ktanino10/copilot-cli-inverted-pendulum-m5stick/docs/demo/assets/duck.gif

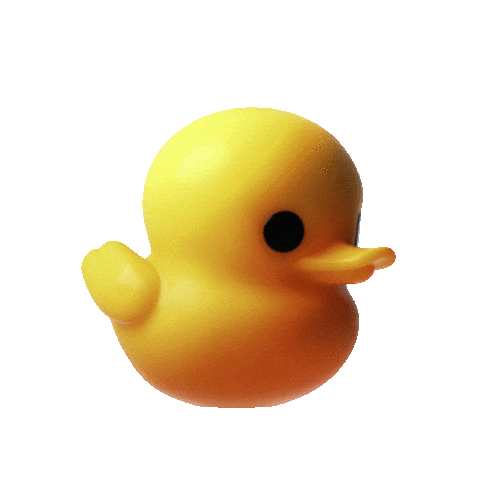
docs/demo/assets/duck.gif
