ktanino10/copilot-cli-inverted-pendulum-m5stick/docs/demo/assets/github-mark.png

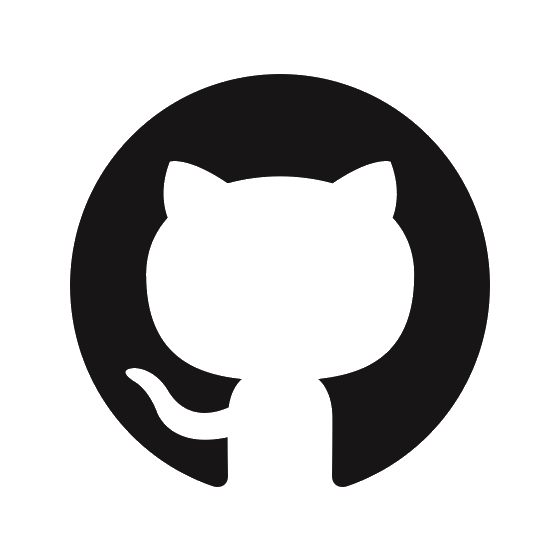
docs/demo/assets/github-mark.png
