ktanino10/copilot-cli-inverted-pendulum-m5stick/media/servo_test_20260418.jpg

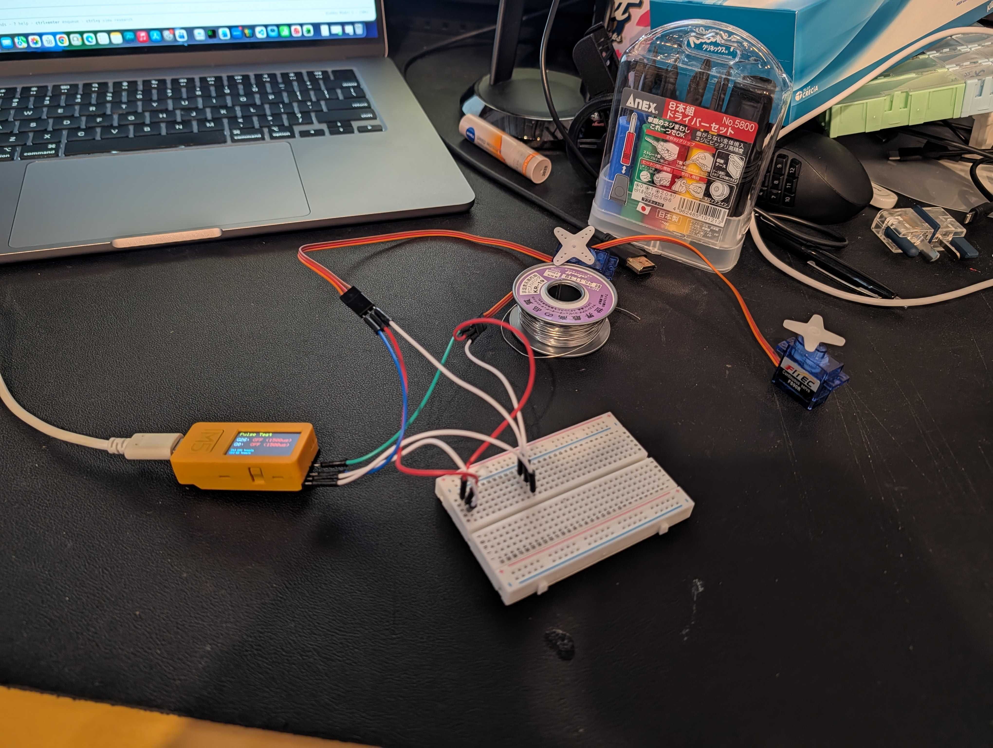
media/servo_test_20260418.jpg
