ktanino10/copilot-cli-inverted-pendulum-m5stick/octocat_display/duck_img.h

// duck - 110x110 RGB565 (byte-swapped, rotated 90° CCW)
const uint16_t duck_img[12100] PROGMEM = {
  0x8208, 0x8208, 0x8208, 0x8208, 0x8208, 0x8208, 0x8208, 0x8208, 0x8208, 0x8208, 0x8208, 0x8208, 0x8208, 0x8208, 0x8208, 0x8208,
  0x8208, 0x8208, 0x8208, 0x8208, 0x8208, 0x8208, 0x8208, 0x8208, 0x8208, 0x8208, 0x8208, 0x8208, 0x8208, 0x8208, 0x8208, 0x8208,
  0x8208, 0x8208, 0x8208, 0x8208, 0x8208, 0x8208, 0x8208, 0x8208, 0x8208, 0x8208, 0x8208, 0x8208, 0x8208, 0x8208, 0x8208, 0x8208,
  0x8208, 0x8208, 0x8208, 0x8208, 0x8208, 0x8208, 0x8208, 0x8208, 0x8208, 0x8208, 0x8208, 0x8208, 0x8208, 0x8208, 0x8208, 0x8208,
  0x8208, 0x8208, 0x8208, 0x8208, 0x8208, 0x8208, 0x8208, 0x8208, 0x8208, 0x8208, 0x8208, 0x8208, 0x8208, 0x8208, 0x8208, 0x8208,
  0x8208, 0x8208, 0x8208, 0x8208, 0x8208, 0x8208, 0x8208, 0x8208, 0x8208, 0x8208, 0x8208, 0x8208, 0x8208, 0x8208, 0x8208, 0x8208,
  0x8208, 0x8208, 0x8208, 0x8208, 0x8208, 0x8208, 0x8208, 0x8208, 0x8208, 0x8208, 0x8208, 0x8208, 0x8208, 0x8208, 0x8208, 0x8208,
  0x8208, 0x8208, 0x8208, 0x8208, 0x8208, 0x8208, 0x8208, 0x8208, 0x8208, 0x8208, 0x8208, 0x8208, 0x8208, 0x8208, 0x8208, 0x8208,
  0x8208, 0x8208, 0x8208, 0x8208, 0x8208, 0x8208, 0x8208, 0x8208, 0x8208, 0x8208, 0x8208, 0x8208, 0x8208, 0x8208, 0x8208, 0x8208,
  0x8208, 0x8208, 0x8208, 0x8208, 0x8208, 0x8208, 0x8208, 0x8208, 0x8208, 0x8208, 0x8208, 0x8208, 0x8208, 0x8208, 0x8208, 0x8208,
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
  0x8208, 0x8208, 0x8208, 0x8208, 0x8208, 0x8208, 0x8208, 0x8208, 0x8208, 0x8208, 0x8208, 0x8208, 0x8208, 0x8208, 0x8208, 0x8208,
  0x8208, 0x8208, 0x8208, 0x8208, 0x8208, 0x8208, 0x8208, 0x8208, 0x8208, 0x8208, 0x8208, 0x8208, 0x8208, 0x8208, 0x8208, 0x8208,
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
};
