ktanino10/copilot-cli-inverted-pendulum-m5stick/(commit log)

2026-04-12 初期セットアップ: README追加
    Interface誌2025年9月号の倒立振子プロジェクトの初期README。
    ハードウェア構成、配線、ライブラリ情報、PIDデフォルト値を記載。
2026-04-12 サーボモータ動作テストスケッチ追加
    FS90Rサーボの動作確認用。Aボタンで正転/逆転/停止を切り替え。
2026-04-13 docs: 購入部品リスト追加
2026-04-13 docs: Copilot CLI プロジェクトとしてREADME刷新 (日英バイリンガル)
2026-04-13 docs: 参考リンクにしんさんのブログ記事を追加
2026-04-15 docs: PID制御 理論編を追加 / Add advanced PID theory reference
    運動方程式（ラグランジュ導出）、状態空間表現、カルマンフィルタの
    完全な定式化、安定性解析（フルビッツ判定）、LQR/MPC/RL等の
    発展的手法を数式付きで解説する上級者向け技術文書を追加。
2026-04-16 docs: replace LaTeX table notation with rendered symbols in pid theory
    Agent-Logs-Url: https://github.com/ktanino10/copilot-cli-inverted-pendulum-m5stick/sessions/5fc2fae2-76e4-4516-99dc-65c427066bf1
2026-04-16 docs: switch display equations to fenced math blocks
    Agent-Logs-Url: https://github.com/ktanino10/copilot-cli-inverted-pendulum-m5stick/sessions/1d5b6d02-fe36-433c-b3ab-e53c90e8f2ca
2026-04-16 fix: 数式を画像レンダリングに変更 / Switch to image-based math rendering
    GitHub の <math-renderer> Web Component がブラウザ環境によって
    動作しない問題を回避するため、codecogs SVG画像に切り替え。
    すべての数式がJavaScript不要で表示可能に。
2026-04-16 feat: M5StickC Plus2 対応 / Port firmware to M5StickC Plus2
    - M5StickCPlus.h → M5StickCPlus2.h に変更
    - M5.Lcd → StickCP2.Display API に移行
    - M5.Imu → StickCP2.Imu.getImuData() に移行
    - M5.Axp.GetBatVoltage() → StickCP2.Power.getBatteryLevel()
    - cfg.output_power = true で5V外部出力を有効化
    - FQBN: m5stack_stickc_plus2
    - servo_test, inverted_pendulum 両方を Plus2 対応済み
2026-04-16 docs: Plus2移植トラブルシュートを進捗ログに追加 / Add Plus2 migration troubleshooting guide
    Plus → Plus2 移植時に発生した4つの問題（画面表示、5V出力、
    ボタン制御、モーター停止）の原因と対策を表形式で記録。
    API対応表も追加し、同じキットでPlus2を使う人の参考に。
2026-04-16 fix: ステッカー画像の色をバイトスワップで修正 / Fix sticker color byte order
    M5GFX(LovyanGFX)のpushImageはバイトスワップされたRGB565を
    期待するため、全4画像のピクセルデータを再変換。
    [copilot_img.h, duck_img.h, mascot_img.h, octocat_img.h]
2026-04-16 feat: Copilot GIFアニメーション再生機能を追加 / Add animated GIF playback
    copilot_sticker.gif を87フレーム(60x60 RGB565)に変換し、
    Bボタンでアニメーション再生/停止。Aボタンで静止画切替。
    Flash使用率36%。
2026-04-16 feat: 全キャラGIFアニメ + 90°回転対応 / All stickers animated & rotated 90° CCW
    Copilot/Duck/Mascot の3キャラをGIFアニメーション再生可能に。
    全画像を反時計回り90°回転（倒立振子搭載時に正面向き）。
    Flash使用率71%。Aボタンで静止画切替、Bボタンでアニメ再生。
2026-04-18 docs: 4/18 両輪駆動成功のログと写真を追加 / Log dual servo success
    pulse_drive方式で両サーボ安定駆動に成功した記録。
    追加の問題2件（パルス漏れ、ボタン応答）と対策を記載。
    テスト時の写真を media/ に追加。
2026-04-18 docs: YouTubeリンクを追加 / Add YouTube video link
    両輪サーボ駆動テストの動画をサムネイル付きで埋め込み。
    https://www.youtube.com/watch?v=syauXEm0TFY
2026-04-18 feat: PID符号修正 + リアルタイムチューニングUI + CSVログ
    - PID出力の符号を反転（車輪が傾き方向に追いかけるように）
    - 全PIDパラメータを0初期化（ゼロからチューニング）
    - BtnA短押し: ON/OFF、長押し: パラメータ選択切替
    - BtnB短押し: 選択中パラメータ+step、長押し: ステップ変更
    - シリアルCSV出力（CERN ROOT解析用データ収集対応）
    - servo_stop()をパルスなし方式に修正
    [inverted_pendulum.ino]
2026-04-18 fix: PITCH_OFFSET削除+角度自動基準+待機短縮 / Fix angle offset and response
    - PITCH_OFFSET=81.0を削除（Angleが常に大きくPID_resetされ続けた原因）
    - ONにした瞬間の角度を基準(Pitch_offset)として自動設定
    - wait_countを200→50に短縮（2秒→0.5秒で応答開始）
    - ANGLE_LIMITを30→45に拡大
    [inverted_pendulum.ino]
2026-04-18 fix: ANGLE_LIMIT超過でモーター自動OFFを無効化
    角度超過時はPIDリセット+サーボ停止だけ行い、motor_swはONのまま。
    直立に戻せば自動復帰。手で支えながらの調整が容易に。
    [inverted_pendulum.ino]
2026-04-18 fix: 両モーター +power/+power に変更
    motor_dir_testで+cmd/+cmdが前進と確認済み。
    前に傾けたら前に進む方向に統一。
    [inverted_pendulum.ino]
2026-04-18 fix: モーター方向を確定 +power/-power（実機テスト済み）
    4パターン方向テストで Mode3(+100/-100) が前進と確認。
    powerL = +power, powerR = -power に確定。
    [inverted_pendulum.ino, motor_dir_test.ino]
2026-04-18 debug: シンプルP制御のみに簡素化+getPitch軸戻し
    方向問題のデバッグ用にPID_ctrlをpower=kp*Angleだけに簡素化。
    Speed/I_Angle等の蓄積を排除して純粋な方向確認。
2026-04-18 fix: getPitch()をasin(-acc[2])に変更 — 前後応答確認！
    IMU軸確認ツールでZ軸が前後傾きと特定。
    atan2では直立付近で符号が正しく反転しなかったため、
    asin(-acc[2])で直接角度変換に変更。
    前=前、後ろ=後ろの動作を実機確認 ✅
    [inverted_pendulum.ino]
2026-04-18 docs: 4/18 方向制御確立のログを追加 / Log direction control establishment
    IMU軸特定手順、モーター方向4パターンテスト、
    確定した制御パラメータ、解決した問題5件を日英で記録。
    他の人が同じハードで作る際のガイドとして。
2026-04-18 fix: getPitch/ジャイロ符号を反転 — 後傾時の方向修正
    後ろに倒れそうなとき前に進んでいた問題を修正。
    asin(-acc[2])→asin(acc[2])、-gyro[2]→gyro[2]に変更。
    [inverted_pendulum.ino]
2026-04-18 feat: Bボタンで直立基準オフセット調整 + PIDゲイン増加
    重心位置のずれに対応するためBボタンでPitch_offsetを±0.5°調整可能に。
    PIDゲインをkp=30, ki=3, kd=2に増加。
2026-04-18 feat: リアルタイムモニター + 自動チューニングスクリプト
    tools/monitor.py: リアルタイムAngle/power表示+コマンド送信+全データCSV自動保存
    tools/auto_tune.py: パラメータスイープで安定時間を自動計測
2026-04-18 data: 42パターン自動PIDスイープ完了！
    最安定パラメータ: kp=10, kd=2 (stable=5.0s, mean_angle=0.1°)
    安定領域: kp=10-25, kd=2-15
    kp=50は高すぎた（振動→倒れる）
    [autotune_20260418_232105.csv]
2026-04-25 refactor: n_shinichi氏準拠のクリーン版に全面書き換え
    重大な差分を全修正:
    - ジャイロ軸: Z軸→X軸（実機テストで確認）
    - getPitch: asin→atan2（n_shinichi氏と同じ）
    - Pitch_offset: 動的→81固定（n_shinichi氏と同じ）
    - PID符号: 二重反転を解消、n_shinichi氏と同じ構造
    - power制限: ±400制限を撤廃
    - I_Angle: constrain→300でリセット（n_shinichi氏と同じ）
    - wait_count: 50→200（n_shinichi氏と同じ）
    - ANGLE_LIMIT: Angle→Pitch_filter、45→30（n_shinichi氏と同じ）
    [inverted_pendulum.ino, motor_dir_test.ino]
2026-04-25 tune: Pitch_offset=82.4 — USB無しで10秒静止達成！🎉
    n_shinichi氏準拠クリーン版 + ジャイロX軸修正の効果で
    BAT端子3.7Vでも10秒間の自立バランスを確認。
    ジャイロ軸の間違い(Z→X)が最大の原因だった。
    [inverted_pendulum.ino]
2026-04-25 fix: ボタン処理を100msループに移動（1秒ループでは反応しない）
2026-04-25 fix: Pitch_offset=2.5（実測値）+ ANGLE_LIMIT復元
    直立時のPitch実測値=-2.5° → offset=2.5で直立=0°に。
    n_shinichi氏の81はIMU取り付け向きが違うため使えなかった。
    ANGLE_LIMIT=±30に戻し、PID_ctrlが正しく起動するように。
    [inverted_pendulum.ino]
2026-04-25 fix: Pitch_offset=0.1（直立USB実測）+ Angle=PF-offset計算修正
    直立状態でUSB繋いでPF=0.1を実測。
    Angle = Pitch_filter - Pitch_offset で直立=0°。
    PIDが正しく動作しモーターが傾きに応答することを確認。
    [inverted_pendulum.ino]
2026-04-25 feat: Z軸直接角度変換+PID符号反転+ANGLE_LIMIT拡大で大進歩
    - getPitch: atan2→acc[2]*90（Z軸直接、符号反転問題を完全回避）
    - PID符号: 反転して正しい方向に
    - ANGLE_LIMIT: ±30→±60（大角度でもPID継続）
    - Pitch_offset: 0（Z軸直接なのでoffset不要）
    - 微細な角度で前後正しく応答、大角度でも方向維持
2026-04-25 fix: atan2境界問題を根本解決 — 直立を0°に移動
    旧: atan2(-acc[2], -acc[1]) → 直立=-89.8°（atan2の±90°境界付近）
    → 前後どちらに傾けても角度がマイナスになり、モーターが片方向のみ
    新: atan2(acc[1], acc[2]) → 直立=0°（境界から遠い安定領域）
    → 前傾=+角度、後傾=-角度で正しく符号が分かれる
    → ±180°境界は横倒し（90°以上）で通常動作に影響なし
    Pitch_offset: -89.8 → 0.0（直立が0°なのでオフセット不要）
    [inverted_pendulum.ino]
2026-04-25 docs: 4/25進捗ログ追加 + atan2符号修正 + README全面更新
    進捗ログ:
    - 4/18: 42パターン自動PIDスイープ + ヒートマップ可視化
    - 4/25: n_shinichi氏コード完全準拠クリーンリライト
    - ジャイロ軸 Z→X 修正（最重要修正）
    - atan2境界問題の発見と解決（直立=-90°→0°に移動）
    - 小角度PID制御成功のシリアルログ記録
    ファームウェア:
    - getPitch(): atan2(-acc[1], acc[2]) に変更
    旧版と同じ符号、直立=0°で安定
    README更新:
    - ハードウェア: Plus→Plus2に更新
    - ライブラリ: RemoteXY削除、M5StickCPlus2追加
    - リポジトリ構成: tools/, motor_dir_test/, octocat_di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
    [inverted_pendulum.ino]
2026-04-30 feat: 転倒ログ診断とROOT可視化を追加
    - 詳細ログX行を追加し、Angle/dAngle/PID項/IMU/出力を記録
    - ON時に現在姿勢を自動ゼロ合わせするzero/reference処理を追加
    - 前後非対称補正とデバッグ用コマンドを追加
    - 速度/最低出力補正の試行結果を反映し、現在は安全側設定に整理
    - failure_log_*.csv を保存
    - visualize_root.pyを詳細ログCSV対応に刷新
    - ROOTファイルとmatplotlib/ROOT PNGを生成
    - READMEに5/1の実験ログ、可視化リンク、次回候補を追記
    [failure_log_backward_run.csv, failure_log_latest.csv, failure_log_oscillation.csv]
2026-04-30 docs: READMEに転倒ログPNGを埋め込み表示
2026-04-30 docs: READMEの理論説明とログ表示を整理
2026-04-30 docs: 理論章に用語補足ブロックを追加
2026-05-01 docs(glossary): convert math to codecogs SVG images for GitHub rendering
    GitHubネイティブの $$...$$ / $...$ 数式表記が用語集ページで
    正しくレンダリングされなかったため、pid_theory.md と同じ
    codecogs SVG 画像埋め込み形式に変換。
2026-05-01 feat(pid): 速度FB極弱で復活 + ANGLE_LIMIT を ±20 へ縮小
    転倒ログ再分析（5/2）の結論を反映:
    1. 純 P+D 制御は backward_run ログでは正常動作していたが、
    速度/位置フィードバックを全部 0 にしたため車輪が振子の真下まで
    走り続けて止まらず、結果として後ろへ逃げる挙動が必然となっていた。
    倒立振子は原理的に「角度＋車輪速度」最低 2 状態フィードバックが必要。
    → kpower=0.0001, kspd=0.15 をデフォルトに復活。
    2. oscillation ログの暴走原因は ANGLE_LIMIT (±45°) を出入りする度に
    PID_reset → 復帰時に大角度（30〜45°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
    [inverted_pendulum.ino]
2026-05-01 tools: arduino-cli を使った書き込みヘルパー upload.sh 追加
    使い方:
    ./tools/upload.sh # コンパイル + 書き込み
    ./tools/upload.sh -c # コンパイルのみ
    ./tools/upload.sh -m # 書き込み後にシリアルモニタを開く
    PORT=/dev/cu.xxx ./tools/upload.sh # ポート上書き
2026-05-01 Add wireless tuning UI: M5 web server + Mac Flask session UI
    - Firmware: WiFi + WebServer on M5StickC Plus2
    - GET / simple mobile UI
    - GET /s full status JSON (angle, dangle, P/I/D, gains)
    - GET /c?q=cmd parameter command (same syntax as serial)
    - WiFi credentials in inverted_pendulum/wifi_config.h (gitignored)
    - Mac server: tools/server.py (Flask on :5000)
    - Hosts rich session UI, proxies API to M5
    - Auto-saves test sessions to tools/data/sessions/{stamp}_{name}.{json,csv}
    - UI: tools/templates/index.html
    - START/STOP test recording with live chart (20Hz polling)
    - Session list, multi-select compare overlay, auto-diagnose hints
    - tools/run_server.sh helper, r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
2026-05-01 feat(ui): Gundam HUD theme — RX-78 / IPS interface
    - Boot sequence with system check log
    - Top status bar: clock, link/motor/power LEDs, serial #
    - Clip-path angular panels with corner brackets
    - Orbitron + Share Tech Mono fonts (Gundam HUD style)
    - Cyan/amber/red mecha color palette with neon glow
    - HUD-style angle gauge with crosshair grid + needle bar
    - Custom slider thumbs (chevron shape)
    - Combat recorder badge with REC pulse
    - Mission archive with FWD/BWD/STANDING pills
    - Tactical analysis chart with multi-trace glow
    - AI diagnostic with mecha-flavored advice strings
2026-05-01 ui: add GitHub mark + 3D stickers (Copilot/Mona/Duck)
    - GitHub mark in header (cyan glow, white-inverted)
    - GitHub mark in boot screen (rotating 8s)
    - Copilot 3D sticker beside AI DIAGNOSTIC heading
    - Mona mascot floating in bottom-right corner
    - Rubber Duck on CONTROL PARAMETERS panel (debugging vibes)
    - Footer credit: POWERED BY GITHUB COPILOT
2026-05-01 Refine UI: drop military terms, transparent Octocat PNG, add toast helper
    - Remove combat/mission/operation/engage/abort wording
    - Convert github-mark.png white background to transparent so the
    brightness/invert/cyan-glow CSS filter renders an Octocat silhouette
    on the dark HUD instead of a white square
    - Add toast(type, mascot, msg) helper with contextual mascot mapping
    (mona = standing success, duck = quick fall / errors, copilot = AI/info)
    - Wire save outcome to contextual toast notifications
2026-05-01 Add /dash analytics dashboard with 7 on-demand analyses
    New page at /dash with Gundam HUD theme, mirrors main UI aesthetic:
    - Session archive (multi-select up to 4, color-coded)
    - KPI grid (duration, stable time, max angle, RMS, peak power, sat%, osc Hz, fall dir)
    - Time-series charts via Chart.js (angle / power / P-D terms / speed)
    with alim band overlay and time normalization toggles
    - Stats & params diff table (auto-highlights cells that differ)
    Analysis bar with 7 buttons that compute and display on demand:
    - 🎯 FALL CAUSE - classify why it fell (saturation / overshoot / oscillation / cutoff / drift)
    - ⚖ SYMMETRY - forward vs backward power response asymmetry, suggests ppos/pneg a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
    [server.py]
2026-05-01 Add JP/EN language toggle, dynamic Mona widget, Copilot intro/welcome
    Language toggle (no emoji, just 'JP' / 'EN' buttons):
    - Lightweight CSS-only i18n via data-en / data-jp attributes
    (body.lang-jp [data-en]{display:none} and vice versa)
    - Persists choice via localStorage
    - Triggers Ducky toast on every language change
    Dynamic Mona widget in ATTITUDE panel:
    - Visualizes system stability through animation speed:
    * |angle| < 5° -> STABLE: slow gentle float (4s)
    * |angle| 5-15° -> WOBBLE: faster bounce (0.9s, amber halo)
    * |angle| >= 15° or |dangle| > 80 -> FALLING: rapid shake (0.18s, red halo + status blink)
    - animation-duration is set via CSS custom property from JS each poll cy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
2026-05-01 Fix i18n: render attribute via ::before; tilt+flip Mona face with angle sign
    - i18n CSS bug: previous rules only set display:none and never rendered
    the data-en/data-jp attribute values, so dual-attr empty spans showed
    nothing. Switched to [data-XX]::before { content: attr(data-XX) } so
    the active language's text actually appears.
    - Mona face now mirrors angle sign: angle >= 0 shows native orientation
    with rotate(+tilt), angle < 0 horizontally flipped (scaleX -1) with
    inverse rotation. Tilt is angle * 0.7 clamped to +/-30 deg, with a
    smooth 120ms transition for natural head tracking.
2026-05-01 Promote language switch to fullscreen Ducky splash overlay
    Replaces the small toast notification with a centered amber-glow overlay
    showing a 280px Ducky GIF, large 'JP' / 'EN' badge with neon glow, and
    mode label ('日本語モード' / 'ENGLISH MODE'). Plays a pop+bob animation
    for ~1.4s then fades out. Applied to both main UI and dashboard.
2026-05-01 feat(ui): dynamic Copilot+Ducky reactions across HUD/dash
    Copilot (analysis/recording companion):
    - TEST RECORDER: live counter (samples · seconds), pulse rate
    accelerates with elapsed time, periodic flash every 5s
    - Save success: Copilot icon scale-pop flash on /api/sessions OK
    - /dash analysis: 0.6s 'thinking' pose before result, then mood
    badge (cyan ok / amber warn / red pulse err) based on result mix
    Ducky (anomaly/debug guardian):
    - ATTITUDE: 'SAT!' Ducky pops next to Mona when |power|>=plim*0.95
    for >300ms; auto-hides on recovery
    - Global: 'LINK LOST' banner slides down from top after 3 consecutive
    /api/s failures; slides out on recovery
    - Fall moment: Ducky rolls right-bott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
2026-05-01 fix(parade): correct mascot filters (Mona was white due to nth-child shift from .pcap span)
2026-05-01 feat(dash): GREEN-zone optimization analyzer (regression + heatmap + bootstrap CI)
    GREEN-zone framework: every analysis result now starts with a banner
    showing % time within +/-5deg (the 'green stable' band) per session,
    the 80%% goal, and the single most-impactful next change to reach it.
    New analyzer 'OPTIMAL -> GREEN':
    - Per-parameter 1D regression: scatter (param value vs green-stay %)
    with moving-block bootstrap 95%% CIs (1s blocks x 400 resamples)
    - Quadratic least-squares fit; reports concavity, R^2, vertex (predicted
    optimum). Marks vertex on chart when concave and inside data range.
    - 2D Gaussian-kernel heatmap when exactly 2 params vary; shows kernel-
    predicted peak with cro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
2026-05-01 revert(ducky): remove fall-moment Ducky roller per user feedback
    Keep other Ducky roles (PWM saturation badge, link-lost banner,
    language-switch splash). Only the fall-moment roller across the screen
    was unwanted.
2026-05-01 Add per-session score + one-click APPLY params; remove fall-time Ducky
    - computeStats now derives green_ratio (% time |angle|<=5deg), mean_abs_angle,
    and a 0-100 score: duration (<=30) + green% (<=50) + tightness (<=20).
    - Server /api/sessions exposes score / green_ratio / mean_abs_angle.
    - Session list rows now show a colored SCORE badge (green/amber/red) and
    an APPLY button that pushes the saved params to the device in one click
    via /api/c. Legacy sessions get a derived score from summary fields.
    - Remove fall-time Ducky displays per request:
    * #duckSat (PWM saturation badge by Mona) and its CSS keyframes
    * QUICK FALL ducky toast -> Mona warn toast
    * drawDiag lead mascot 'duck'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
    [server.py]
2026-05-01 Boot screen: SEED-style live system check sequence
    Replace static 1.8s boot animation with a live diagnostic that types
    each line, runs a real probe, and reports OK / WARN / FAIL with a
    color-coded verdict. Lines (in order):
    HUD INTERFACE / DOM
    NETWORK STACK (navigator.onLine)
    TUNING SERVER · LOCAL API (GET /api/sessions)
    WI-FI LINK · M5STICKC (GET /api/s with 1.5s timeout)
    IMU · MPU6886 (angle field + sanity)
    KALMAN FILTER (dangle field)
    MOTOR DRIVER · DRV8833 (on field — WARN if already engaged)
    POWER · LIPO BATTERY (batt voltage thresholds)
    PID CONTROLLER (kp/kd/pneg/bias loaded)
    SESSION ARCHIVE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
2026-05-01 GitHub Pages demo + portable multi-SSID firmware
    ═══ GitHub Pages demo (docs/demo/) ═══
    Build a fully self-contained static demo of the IPS Command UI so the
    project can be browsed without owning the hardware.
    * docs/demo/index.html — generated copy of tools/templates/index.html
    with absolute /assets/ paths rewritten and a window.IPS_DEMO=true
    flag injected.
    * tools/templates/index.html now contains a demoShim() that, when
    IPS_DEMO is set, intercepts every /api/* fetch:
    GET /api/s -> simulated 50 Hz device telemetry
    GET /api/c?q=k=v -> mutates the simulated state
    GET /api/sessions -> bundled data/sessions/index.json
    GET /api/sessions/x -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
2026-05-01 Add today's progress log + dedicated WiFi/comm guide
    * README §進捗ログ: '2026-05-02' entry covering today's full work —
    STATS LAB analytics, mascot animations, i18n, score + APPLY,
    removal of fall-time Ducky, SEED-style boot diagnostic,
    GitHub Pages demo, multi-SSID + AP fallback firmware. Includes a
    condensed commit list and follow-up ideas.
    * docs/wifi_communication.md (new, 8.7 KB): two-part communication
    guide.
    Part 1 (beginner): cast of three actors (browser / Flask / M5),
    what WiFi is, what an SSID/IP is, what happens when you change
    location, intuitive explanation of multi-SSID, AP fallback,
    Tailscale, GitHub Pages demo. Heavy use of analogies.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
2026-05-01 chore(privacy): replace hardcoded home LAN IP with AP fallback default
    Default M5_URL was a private LAN IP that leaked the user's home
    subnet pattern. Switch to 192.168.4.1 (the firmware's AP-mode
    fallback IP), which works out-of-the-box when the controller
    boots into IPS-CTRL access point and is not tied to any specific
    home network.
    [server.py]
2026-05-02 build(demo): bake LIVE password hash
    SHA-256 only — the password itself never enters the repository.
    Visitors must triple-tap the bottom-right corner, supply the password,
    AND know the private Backend URL (Tailscale IP) to control real hardware.
2026-05-02 feat(demo): bake Tailscale default URL + add cloudflared fallback script
    - docs/demo/index.html: pre-fill LIVE-mode prompt with home Tailscale IP
    so the owner doesn't have to re-type it on every device. The address
    is in Tailscale's CGNAT range (100.x.y.z) — only reachable from the
    owner's own tailnet, so no real exposure even though it's public.
    - tools/start_tunnel.sh: optional Cloudflare Quick Tunnel launcher as a
    Tailscale-free fallback (random *.trycloudflare.com URL, no signup).
2026-05-02 fix(privacy): don't bake personal Tailscale IP into public HTML
    Previous commit (5e44bb8) baked the owner's Tailscale CGNAT IP
    into docs/demo/index.html as a 'convenient' default URL. While
    100.x.y.z is unreachable from outside the owner's tailnet, it
    still leaks 'this person uses Tailscale + their tailnet ID' to
    anyone reading the public Pages source. That is inconsistent
    with the broader effort to externalise hardcoded values
    (commit b44d9fe and a6e6e54).
    Now the LIVE-mode prompt starts blank on the first visit per
    device. After the first successful unlock, localStorage
    remembers the URL — so the convenience cost is one paste per
    new device, ever.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
2026-05-02 docs: prominent 'Launch Demo' button in README + landing page
    - README: shields.io 'LAUNCH DEMO' badge directly under title +
    a quick-start table linking to the live demo
    - docs/index.html: was a 0-second silent redirect; now shows a
    visible green button + 2-second redirect so visitors who land
    on the bare /docs/ URL immediately see and can click LAUNCH
2026-05-02 demo: fix /dash 404 + close button; remove owner-only operating notes from public docs
    - Extract liveGate/demoShim into shared tools/templates/_demo_shim.js, used
    by both index.html and dash.html (fixes 404 on the analysis button).
    - Add a small ✕ CLOSE button (top-left, demo/owner only) that returns the
    visitor to the GitHub repo URL.
    - build_demo.py now processes both index.html and dash.html, copies the
    shim alongside, and rewrites internal Flask paths to the static layout.
    - Remove owner-only operating procedure (gesture, password flow, etc.)
    from README.md and docs/wifi_communication.md so the public docs only
    show the demo as a UI showcase. Implementation files keep the mec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
    [build_demo.py, local_config.example.py]
2026-05-02 demo: move ✕ CLOSE button to bottom-right with tap-guard
    Bottom-right corner is also the LIVE gate's 3-tap unlock zone, so:
    - ✕ CLOSE itself stopPropagation()s its click and touchend events
    - liveGate's corner() ignores events whose target is inside #ipsCloseBtn
    Belt-and-braces ensures clicking the close link never accidentally
    counts toward the 3-tap unlock and never pops the password prompt.
2026-05-03 README: add real-world success video at the top
    Embeds the YouTube thumbnail (https://www.youtube.com/watch?v=MdE459HKGWA)
    of the M5StickC Plus self-balancing while the browser dashboard streams
    live telemetry — the most compelling proof that the project works.
    Placed between the badges and the LAUNCH DEMO buttons so it is the
    first visual element after the title block.
2026-05-03 demo: ship 9 real captured sessions instead of synthetic ones
    Switches docs/demo/data/sessions/ from build-time synthetic data to
    the actual M5 captures saved by tools/server.py.
    build_demo.py now:
    - Loads tools/data/sessions/*.json (real captures)
    - Skips entries lacking modern stats (score/green_ratio)
    - Renames them to live-run-01..NN in chronological order
    - Falls back to the curated synthetic set when no real captures exist
    Result: visitors to the GitHub Pages demo see the same 9 runs that
    produced the YouTube success video (live-run-09 reaches score=65).
    [build_demo.py]
2026-05-03 demo: include nested stats in index.json so dash.html row rendering works
    dash.html's renderList() reads s.stats.fall_dir / s.stats.max_abs_angle
    when laying out the session list, but the prior index.json only
    had those fields flattened to the top level (a long-standing bug
    that was masked by the synthetic data's short narrative names).
    Now each index entry carries BOTH:
    - flat fields (back-compat: max_abs_angle, fall_dir, score, ...)
    - nested 'stats' object (what the dashboard actually consumes)
    Without this, the 9 real sessions appeared in the list with '?'
    fall direction and missing angle/freq KPIs, looking 'not lined up'.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
    [build_demo.py]
2026-05-03 fix(demo): /api/sessions was being swallowed by /api/s startsWith check
    The demoShim fetch override used url.startsWith('/api/s') for the device
    status endpoint, which also matched /api/sessions and /api/sessions/<id>.
    Result: dash.html and index.html received the device state object instead
    of the sessions list, allSessions.length was undefined, and both panels
    showed 'no sessions saved yet' even though docs/demo/data/sessions/
    contained 9 real captures.
    Reorder branches so the more specific /api/sessions* matches first, and
    tighten the /api/s and /api/c checks to require an exact match or '?'
    query separator. Verified via headless puppeteer:
    - dash.html: index.json fetched 200, 9 rows r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
2026-05-03 docs(readme): add Acknowledgments to original kit creators (JP & EN)
    Add an explicit 謝辞 / Acknowledgments section to credit:
    - n_shinichi (しんさん) — original Interface Magazine kit creator,
    author of the sample sketches and blog post that this firmware
    is derived from
    - Interface Magazine / CQ Publishing — for the kit and the article
    Also restore the missing ### 参考資料 heading on the JP side (the
    bullet list was previously orphaned without a heading) and place
    Acknowledgments immediately above References on both halves.
    This repository is a personal learning record built on top of their
    prior work; the new section makes that respect explicit and points
    reade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
2026-05-03 docs(readme): extract progress log to log/ directory
    The 'Progress Log' / '進捗ログ・実験ログ' section was 600+ lines of
    detailed daily experiment notes (2026-04-13 → 2026-05-02), making the
    README hard to scan for first-time visitors.
    Move the full content to:
    - log/progress-log.ja.md (Japanese, 470 lines)
    - log/progress-log.en.md (English, 196 lines)
    Replace the in-README sections with a brief milestone table and a link
    to the extracted file. Each log file has a back-link to README and a
    cross-link to the other language version.
    README is now 757 lines (was 1357 → 44% reduction) while no information
    is lost.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
2026-05-03 feat: dashboard widget to switch M5 target IP at runtime (no restart)
    When the device moves between locations its IP changes:
    home WiFi → 192.168.10.32 (static via local_config.py)
    Pixel hotspot → 10.39.x.x (DHCP, varies each session)
    AP fallback → 192.168.4.1 (fixed when no SSID matches)
    Until now switching meant editing tools/local_config.py and restarting
    server.py. Add a tiny floating widget at the top-right of every page
    that lets the user retarget M5 from the browser, in seconds.
    Backend (tools/server.py):
    - Replace immutable M5_BASE constant with mutable _runtime['m5_base']
    - GET /api/m5_target → returns current target URL
    - POST /api/m5_target {url: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
    [server.py]
2026-05-03 ui(dashboard): move M5 target widget to top-center, drop emoji
    Was overlapping with the LIVE badge / .copilot-mood icon at top-right.
    Centered above the page title where it doesn't collide with anything.
    Also dropped the 🎯 prefix per request — just 'M5: <url>' now.
2026-05-03 chore(repo): full cleanup pass + bilingual log catch-up
    Repo hygiene:
    - Add MIT LICENSE with acknowledgment for n_shinichi (original kit author)
    - Untrack stray .DS_Store files (already gitignored)
    - Remove tools/start_tunnel.sh (Cloudflare quick tunnel — never used in practice)
    Tailscale removal (decided not to use VPN remote ops in the end):
    - Strip all Tailscale references from README, docs/wifi_communication.md, log/progress-log.md
    - Renumber wifi_communication.md sections after removal of §1-6 and §2-8
    - Replace tunnel-IP example in tools/local_config.example.py with phone-tether DHCP example
    - Replace Tailscale wording in LIVE-mode prompt of _demo_shim.js with home/phone-tether wo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
    [local_config.example.py]
2026-05-03 feat(mona-link): stream dashboard mascot to M5 LCD over network
    Add 🔗 LINK MONA / 🔓 UNLINK toggle on the dashboard so the user can
    mirror the angle-reactive Mona mascot from the browser onto the M5StickC
    Plus2's LCD in real time. Off by default — IP/SSID stays visible while
    the user is configuring the device.
    Architecture
    - Dashboard POST /api/lcd_link {on:true} → server.py spawns a daemon
    thread that, every 200 ms (5 FPS), grabs the next mascot.gif frame via
    Pillow, resizes to 80×80, draws a state-colored 4 px border tinted by
    |Angle| (gray=off / green=calm / amber=warn / red=crit, advancing
    frames 2× in crit), JPEG-encodes (~2 KB), and POSTs to http://M5/face.
    - M5 fir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
2026-05-03 feat(mona-link+docs): full-screen mascot, Core 0 display task, parameter guide, A/B video evidence
    Firmware (inverted_pendulum.ino):
    - Split LCD render to a dedicated Core 0 FreeRTOS task (displayTaskFn)
    - Add g_face_buf_mutex; handleFace try-takes with timeout 0 and drops frames
    - Remove updateDisplay() from loop()'s 100ms branch so Core 1 PID never blocks
    Dashboard / server (tools/server.py + _demo_shim.js):
    - LINK MONA: fill full screen with state color (black/green/yellow/red)
    - Ripple ring + bilingual JP/EN label, smoother updates
    - IP/Linked widget moved below 接続/モーター/電源 row to avoid Ducky overlap
    Docs:
    - New docs/parameters.md (~13KB JP+EN): full control variable ref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
    [inverted_pendulum.ino, server.py]
2026-05-04 docs(README): remove LINK MONA A/B comparison section
    The full A/B precision-regression story (3 videos + cause analysis)
    already lives in log/progress-log.md. Keeping it duplicated in the
    top-level README made the landing page noisy. The README's changelog
    row that summarises the investigation is preserved.
